jackoske/HagiwoKick_THT/README.md

# HagiwoKick

# Notes / Design Issues

- Q: Provide 5v from Arduino or directly from Eurorack 5V rail. A: We chose the former
- Patch submodule uses 22uF ceramic instead of 10uF electrolytic

# ToDo

Place capacitors closer to the Arduino, if that's what we want to supress noise on
