jackoske/HagiwoKick_THT/HagiwoKick.kicad_pcb

## KiCad design HagiwoKick.kicad_pcb (2025-03-05)

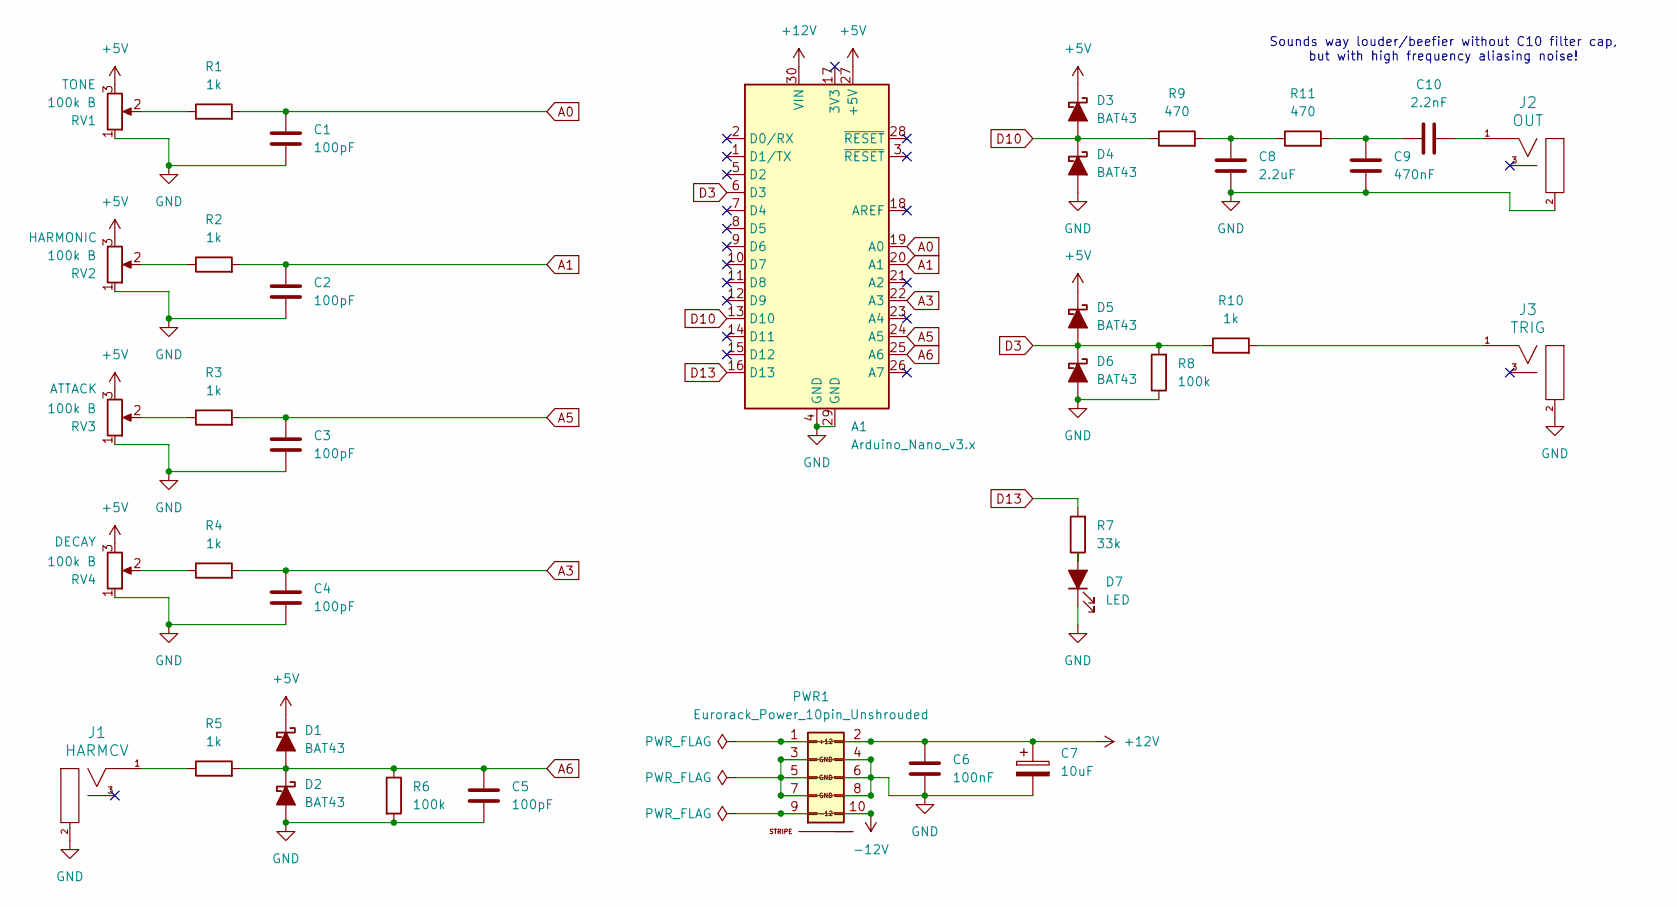
[picture p1: schematic HagiwoKick.kicad_sch, Hagiwo Kick THT]

Parts:
A1: Arduino_Nano_v3.x; Arduino_Nano
C1, C2, C3, C4, C5: 100pF; C_Disc_D3.8mm_W2.6mm_P2.50mm
C6: 100nF; C_Disc_D3.8mm_W2.6mm_P2.50mm
C7: 10uF; CP_Radial_D4.0mm_P2.00mm
C8: 2.2uF; C_Disc_D3.8mm_W2.6mm_P2.50mm
C9: 470nF; C_Disc_D3.8mm_W2.6mm_P2.50mm
C10: 2.2nF; C_Disc_D3.8mm_W2.6mm_P2.50mm
D1, D2, D3, D4, D5, D6: BAT43; D_DO-35_SOD27_P7.62mm_Horizontal_Widened_No_K
D7: LED; LED_D5.0mm
J1: HARMCV; EighthInch_PJ398SM_3mmNPTH; Part Number WQP-WQP518MA
J2: OUT; EighthInch_PJ398SM_3mmNPTH; Part Number WQP-WQP518MA
J3: TRIG; EighthInch_PJ398SM_3mmNPTH; Part Number WQP-WQP518MA
PWR1: Eurorack_Power_10pin_Unshrouded; IDC-Header_2x05_P2.54mm_Vertical_Euro_Power_Striped_Thicker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; Part Number 1-1002FBV0T
R1, R2, R3, R4, R5, R10: 1k; R_Axial_DIN0207_L6.3mm_D2.5mm_P7.62mm_Horizontal
R6, R8: 100k; R_Axial_DIN0207_L6.3mm_D2.5mm_P7.62mm_Horizontal
R7: 33k; R_Axial_DIN0207_L6.3mm_D2.5mm_P7.62mm_Horizontal
R9, R11: 470; R_Axial_DIN0207_L6.3mm_D2.5mm_P7.62mm_Horizontal
RV1, RV2, RV3, RV4: 100k B; Pot_9mm_DShaft_RemovedPins4_5

Connections:
+5V: A1.27 (+5V), D1.1 (K), D3.1 (K), D5.1 (K), RV1.3, RV2.3, RV3.3, RV4.3
+12V: A1.30 (VIN), C6.1, C7.1, PWR1.1 (+12V), PWR1.2 (+12V)
-12V: PWR1.9 (-12V), PWR1.10 (-12V)
A0: A1.19 (A0), C1.1, R1.2
A1: A1.20 (A1), C2.1, R2.2
A3: A1.22 (A3), C4.1, R4.2
A5: A1.24 (A5), C3.1, R3.2
A6: A1.25 (A6), C5.1, D1.2 (A), D2.1 (K), R5.2, R6.1
D3: A1.6 (D3), D5.2 (A), D6.1 (K), R8.2, R10.1
D10: A1.13 (D10), D3.2 (A), D4.1 (K), R9.1
D13: A1.16 (D13), R7.2
GND: A1.4 (GND), A1.29 (GND), C1.2, C2.2, C3.2, C4.2, C5.2, C6.2, C7.2, C8.2, C9.2, D2.2 (A), D4.2 (A), D6.2 (A), D7.1 (K), J1.2 (SHEILD), J2.2 (SHEILD), J3.2 (SHEILD), PWR1.3 (GND), PWR1.4 (GND), PWR1.5 (GND), PWR1.6 (GND), PWR1.7 (GND), PWR1.8 (GND), R6.2, R8.1, RV1.1, RV2.1, RV3.1, RV4.1
unnamed: C8.1, R9.2, R11.1
unnamed: C9.1, C10.1, R11.2
unnamed: D7.2 (A), R7.1
unnamed: J1.1 (SIG), R5.1
unnamed: C10.2, J2.1 (SIG)
unnamed: J3.1 (SIG), R10.2
unnamed: R1.1, RV1.2
unnamed: R2.1, RV2.2
unnamed: R3.1, RV3.2
unnamed: R4.1, RV4.2

Notes on the sheet:
Sounds way louder/beefier without C10 filter cap, but with high frequency aliasing noise!

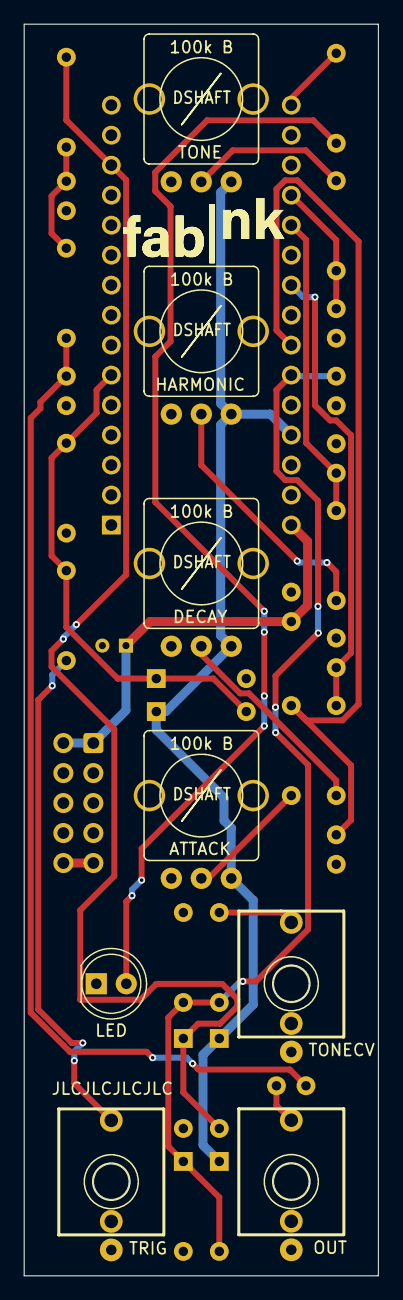
[picture p2: board HagiwoKick.kicad_pcb from above]

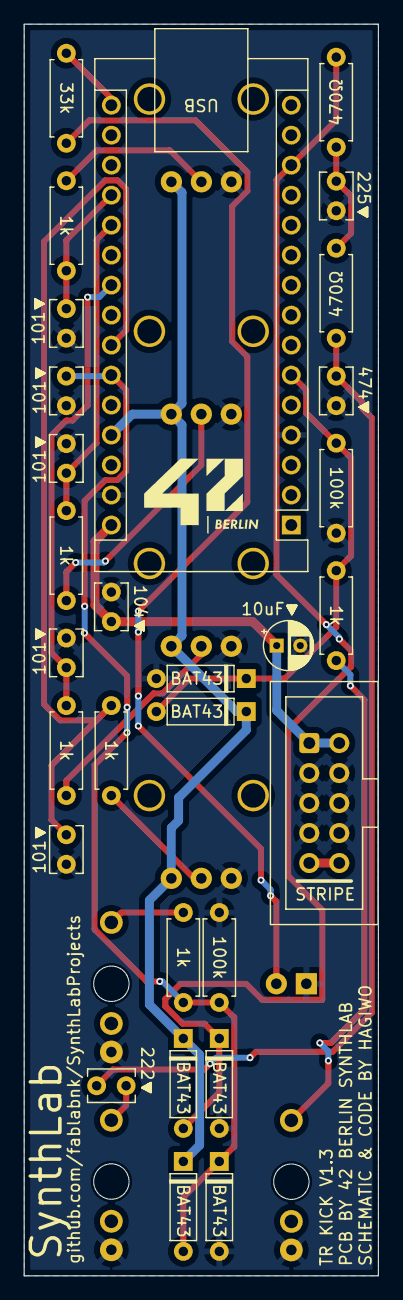
[picture p3: board HagiwoKick.kicad_pcb from below]

Board: 2 copper layers, 30.0 x 106.0 mm, 37 parts (29 on the bottom side), 22 nets.
