jackoske/HagiwoKick_THT/(commit log)

2024-08-13 latest updates
    [HagiwoKick.kicad_pcb, HagiwoKick.kicad_sch, HagiwoKick_Panel.kicad_pcb, bom-old.csv, bom.csv, designators.csv, positions.csv]
2024-09-15 Added BuildNotes.md. Removed production folder
    [bom.csv, designators.csv, positions.csv]
2024-09-22 v1.1 ready for final check
    [HagiwoKick.kicad_pcb, HagiwoKick.kicad_sch]
2024-12-01 updating after Dmitri's changes
    [HagiwoKick.kicad_pcb, HagiwoKick.kicad_sch, HagiwoKick_Panel.kicad_pcb, bom-old.csv, bom.csv, designators.csv, positions.csv]
2024-12-14 switched positions of TRIG and OUT outputs
    [HagiwoKick.kicad_pcb, HagiwoKick.kicad_sch]
2024-12-14 reversed orientated of pots on schematic to make +5V rightmost pin and updated routing. This completes v1.2
    [HagiwoKick.kicad_pcb, HagiwoKick.kicad_sch]
2024-12-15 added v1.2 production files
    [bom.csv, designators.csv, positions.csv]
2025-01-11 minor repositioning - V1.2 ready for fabrication
    [HagiwoKick.kicad_pcb, positions.csv]
2025-02-12 adding second lasercut ready template wth black and readme
2025-02-25 corrected silkscreening issue that TUNE should be TONE and other minor fixed for v1.3
    [HagiwoKick.kicad_pcb, HagiwoKick.kicad_sch]
2025-02-26 flipped knob_tone in code to account for the pot wiring in our circuit
    [HagiwoKick.ino]
